patrickdarke/RadarScopeP4/(commit log)

2026-07-18 RadarScope P4: RD-03D mmWave radar display for CrowPanel Advance 5" ESP32-P4
    Port of Stevee87/Arduino-ESP32-Radarproject's Arduino GIGA receiver.
    Drop-in compatible with the stock XIAO S3 + RD-03D UDP sender; adds
    SIM mode, I2S sonar pings, and an anti-aliased renderer (analytic
    scope background, AA markers/panels, baked Inconsolata font).
2026-07-18 Add untethered sender firmware with battery telemetry + wiring diagram
    sender/: XIAO ESP32-S3 sketch based on the upstream transmitter — LiPo on
    the XIAO's built-in charger (no TP4056/boost/indicator), 220k/220k battery
    divider on A2, battery mV/% appended to the UDP packet (backward-compatible
    32-byte prefix), Wi-Fi modem sleep, 5 Hz send rate, LED heartbeat.
    Display: accepts both packet sizes and shows the sender battery in the info
    panel (green/amber/red). docs/wiring.svg: node wiring incl. the 18650-shield
    fallback if the RD-03D won't run on 3.3 V.
    [RadarScopeP4.ino, radar_ui.cpp, radar_ui.h, sender.ino]
2026-07-18 README: credit and thank Stevee87's Arduino-ESP32-Radarproject
2026-07-18 Add display-unit diagram (docs/wiring_display.svg)
2026-07-19 Add PARTS.md: full BOM with source links
2026-07-20 Redraw sender wiring diagram: true point-to-point power wiring, no line crossings
2026-07-20 Motion-tracker audio + sonar sweep; verified on hardware
    - pinger.cpp: sample playback replaces sine synthesis. Two synthesized
    clips (audio_clips.h, generated by tools/gen_audio.py): idle scan blip
    and contact ping, pure tones shaped by envelopes demodulated from a
    reference recording of the film scene (real warble + echo pulse).
    - Distance curves matched to the reference: interval 1.25 s -> 150 ms,
    pitch 1675 -> 2150 Hz with a front-loaded t^2 sweep. Volume halved.
    - Free-running radiating sweep pulse (radar_ui drawPulse): origin -> rim
    every 3.5 s, AA ring band clipped to the fan.
    - SIM mode: one walker (clean distance->sound judgement).
    - First hardware bring-up complete: flash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
    [RadarScopeP4.ino, pinger.cpp, pinger.h, radar_ui.cpp, radar_ui.h]
2026-07-20 Add audio regression test + rendered approach demo
    tools/test_audio.py simulates the firmware's exact output (clip data from
    audio_clips.h, pinger cadence/pitch/gain) for an 8 m -> 0.3 m approach,
    writes docs/audio_demo.wav, and asserts the measured pitch and tempo
    endpoints (1675/2150 Hz, 1250/150 ms). All checks pass.
